ibuki2003/nanoradio/board/miniradio0913.kicad_pcb

## KiCad design board/miniradio0913.kicad_pcb (2024-10-18)

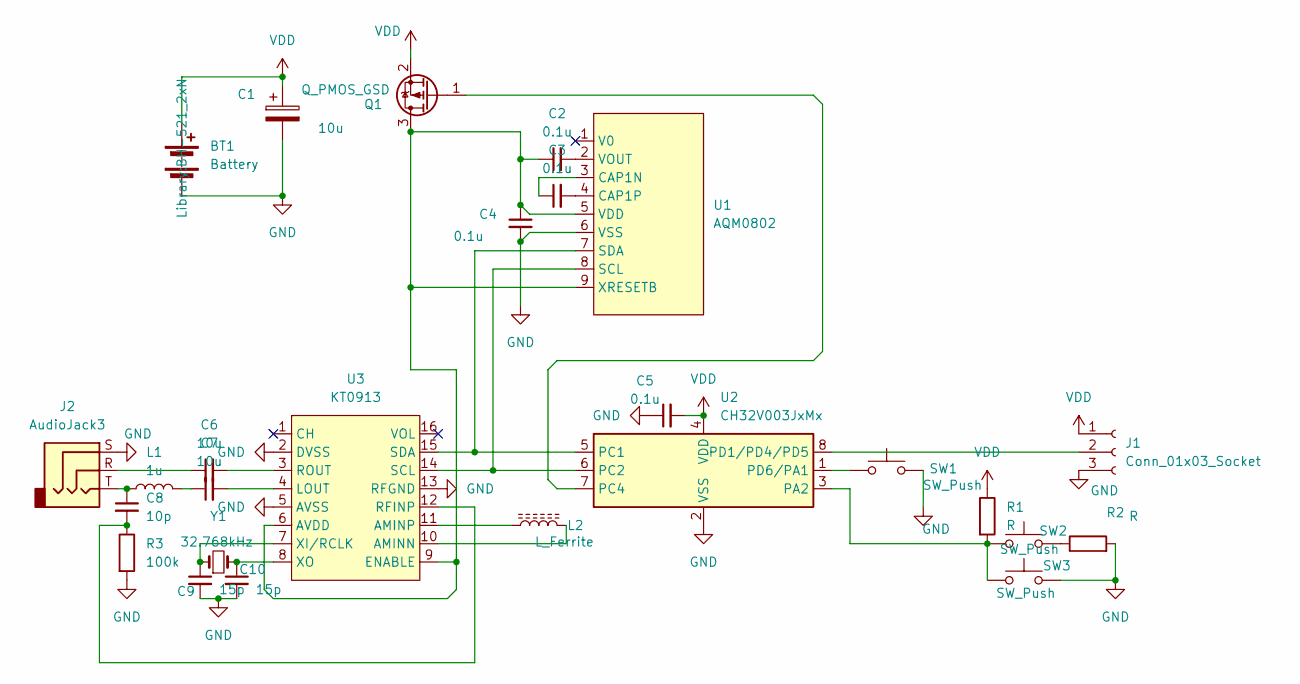
[picture p1: schematic miniradio0913.kicad_sch]

Parts:
BT1: Battery; BH-521_2xN
C1, C6, C7: 10u; C_0603_1608Metric
C2, C3, C4, C5: 0.1u; C_0603_1608Metric
C8: 10p; C_0603_1608Metric
C9, C10: 15p; C_0603_1608Metric
J1: Conn_01x03_Socket; DebugPoint_2.54mmx3
J2: AudioJack3; Jack_3.5mm_Switronic_ST-005-G_horizontal
L1: 1u; L_0603_1608Metric
L2: L_Ferrite; L_Axial_L7.0mm_D3.3mm_P10.16mm_Horizontal_Fastron_MICC
Q1: Q_PMOS_GSD; SOT-23
R1, R2: R; R_0603_1608Metric
R3: 100k; R_0603_1608Metric
SW1, SW2, SW3: SW_Push; SW_SPST_PTS810
U1: AQM0802; AQM0802A
U2: CH32V003JxMx; SOP-8_3.9x4.9mm_P1.27mm
U3: KT0913; SSOP-16_3.9x4.9mm_P0.635mm
Y1: 32.768kHz; Crystal_SMD_3215-2Pin_3.2x1.5mm

Connections:
GND: BT1.2 (-), C1.2, C4.2, C5.1, C9.2, C10.2, J1.3, J2.S, R2.2, R3.2, SW1.2, SW3.2, U1.6 (VSS), U2.2 (VSS), U3.2 (DVSS), U3.5 (AVSS), U3.13 (RFGND)
unnamed: C6.1, J2.R
unnamed: C7.1, L1.2
unnamed: C8.1, J2.T, L1.1
unnamed: J1.2, U2.8 (PD1/PD4/PD5)
unnamed: C2.1, C4.1, Q1.3 (D), U1.5 (VDD), U1.9 (XRESETB), U3.6 (AVDD), U3.9 (ENABLE)
unnamed: Q1.1 (G), U2.7 (PC4)
unnamed: R2.1, SW2.2
unnamed: C3.1, U1.3 (CAP1N)
unnamed: C3.2, U1.4 (CAP1P)
unnamed: U1.8 (SCL), U2.6 (PC2), U3.14 (SCL)
unnamed: U1.7 (SDA), U2.5 (PC1), U3.15 (SDA)
unnamed: C2.2, U1.2 (VOUT)
unnamed: R1.2, SW2.1, SW3.1, U2.3 (PA2)
unnamed: SW1.1, U2.1 (PD6/PA1)
unnamed: L2.1, U3.10 (AMINN)
unnamed: L2.2, U3.11 (AMINP)
unnamed: C7.2, U3.4 (LOUT)
unnamed: C8.2, R3.1, U3.12 (RFINP)
unnamed: C6.2, U3.3 (ROUT)
unnamed: C9.1, U3.7 (XI/RCLK), Y1.1
unnamed: C10.1, U3.8 (XO), Y1.2
VDD: BT1.1 (+), C1.1, C5.2, J1.1, Q1.2 (S), R1.1, U2.4 (VDD)

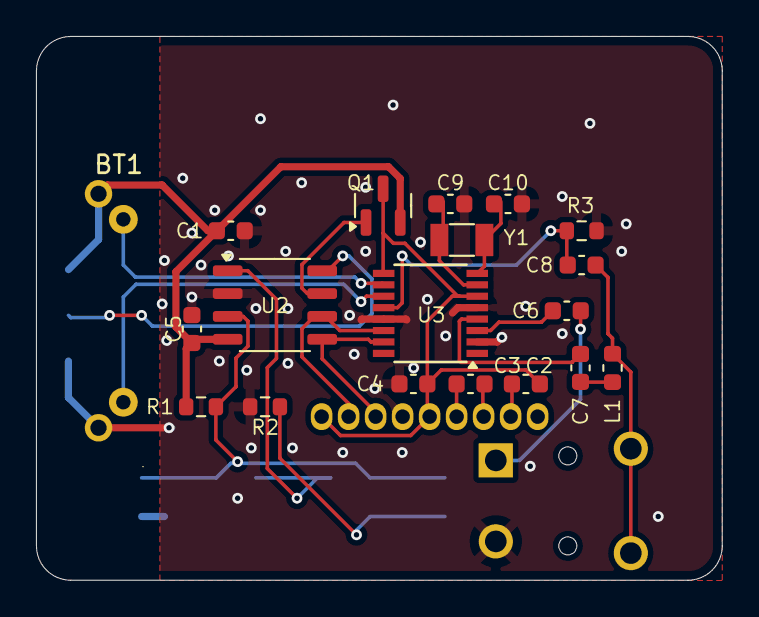
[picture p2: board miniradio0913.kicad_pcb from above]

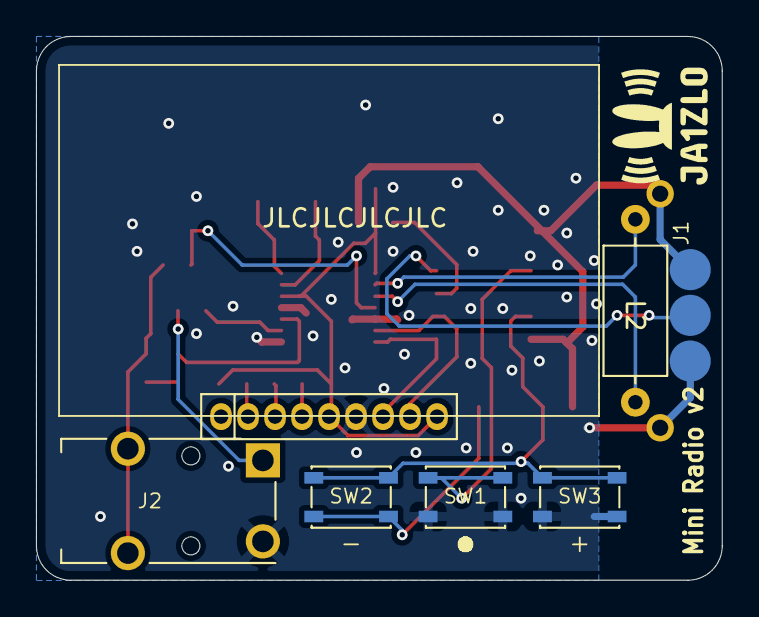
[picture p3: board miniradio0913.kicad_pcb from below]

Board: 2 copper layers, 38.1 x 30.2 mm, 26 parts (7 on the bottom side), 23 nets.
