ibuki2003/nanoradio/program/src/lcd_kana.h

#pragma once

#define ｡ "\xa1"
#define ｢ "\xa2"
#define ｣ "\xa3"
#define ､ "\xa4"
#define ･ "\xa5"
#define ｦ "\xa6"
#define ｧ "\xa7"
#define ｨ "\xa8"
#define ｩ "\xa9"
#define ｪ "\xaa"
#define ｫ "\xab"
#define ｬ "\xac"
#define ｭ "\xad"
#define ｮ "\xae"
#define ｯ "\xaf"

#define ｰ "\xb0"
#define ｱ "\xb1"
#define ｲ "\xb2"
#define ｳ "\xb3"
#define ｴ "\xb4"
#define ｵ "\xb5"
#define ｶ "\xb6"
#define ｷ "\xb7"
#define ｸ "\xb8"
#define ｹ "\xb9"
#define ｺ "\xba"
#define ｻ "\xbb"
#define ｼ "\xbc"
#define ｽ "\xbd"
#define ｾ "\xbe"
#define ｿ "\xbf"

#define ﾀ "\xc0"
#define ﾁ "\xc1"
#define ﾂ "\xc2"
#define ﾃ "\xc3"
#define ﾄ "\xc4"
#define ﾅ "\xc5"
#define ﾆ "\xc6"
#define ﾇ "\xc7"
#define ﾈ "\xc8"
#define ﾉ "\xc9"
#define ﾊ "\xca"
#define ﾋ "\xcb"
#define ﾌ "\xcc"
#define ﾍ "\xcd"
#define ﾎ "\xce"
#define ﾏ "\xcf"

#define ﾐ "\xd0"
#define ﾑ "\xd1"
#define ﾒ "\xd2"
#define ﾓ "\xd3"
#define ﾔ "\xd4"
#define ﾕ "\xd5"
#define ﾖ "\xd6"
#define ﾗ "\xd7"
#define ﾘ "\xd8"
#define ﾙ "\xd9"
#define ﾚ "\xda"
#define ﾛ "\xdb"
#define ﾜ "\xdc"
#define ﾝ "\xdd"
#define ﾞ "\xde"
#define ﾟ "\xdf"
