ibuki2003/nanoradio/program/src/i2c.c

#include "i2c.h"
#include <ch32v003fun.h>

uint8_t i2c_send(uint8_t addr, const uint8_t *data, uint8_t sz);
uint8_t i2c_recv(uint8_t addr, uint8_t *data, uint8_t sz);
uint8_t i2c_send_recv(uint8_t addr, const uint8_t* send, uint8_t send_size, uint8_t* recv, uint8_t recv_size);

#define TIMEOUT_MAX 100000
#define WAIT_WHILE_TIMEOUT(expr) { int32_t timeout = TIMEOUT_MAX; while((expr) && --timeout); if(timeout==0) return 1; }

inline static uint8_t i2c_chk_evt(uint32_t event_mask) {
  /* read order matters here! STAR1 before STAR2!! */
  uint32_t status = I2C1->STAR1 | (I2C1->STAR2<<16);
  return (status & event_mask) == event_mask;
}

uint8_t i2c_raw_start(uint8_t addr, bool recv)
{
  // start

  // Set START condition
  I2C1->CTLR1 |= I2C_CTLR1_START | (recv ? I2C_CTLR1_ACK : 0);

  // wait for master mode select
  WAIT_WHILE_TIMEOUT(!i2c_chk_evt(I2C_EVENT_MASTER_MODE_SELECT));

  // send 7-bit address + write flag
  I2C1->DATAR = addr<<1 | (recv ? 1 : 0);

  // wait for condition
  if (recv) {
    WAIT_WHILE_TIMEOUT(!i2c_chk_evt(I2C_EVENT_MASTER_RECEIVER_MODE_SELECTED));
  } else {
    WAIT_WHILE_TIMEOUT(!i2c_chk_evt(I2C_EVENT_MASTER_TRANSMITTER_MODE_SELECTED));
  }

  return 0;
}

uint8_t i2c_raw_send(const uint8_t *data, uint8_t sz, bool last)
{

  // send data one byte at a time
  while(sz--) {
    // wait for TX Empty
    WAIT_WHILE_TIMEOUT(!(I2C1->STAR1 & I2C_STAR1_TXE));

    // send command
    I2C1->DATAR = *data++;
  }

  if (last) {

    // wait for tx complete
    WAIT_WHILE_TIMEOUT(!i2c_chk_evt(I2C_EVENT_MASTER_BYTE_TRANSMITTED));

    // set STOP condition
    I2C1->CTLR1 |= I2C_CTLR1_STOP;
  }

  // we're happy
  return 0;
}

uint8_t i2c_raw_recv(uint8_t *data, uint8_t sz, bool last)
{

  // send data one byte at a time
  while(sz--) {
    if (sz == 0) {
      // last
      I2C1->CTLR1 |= I2C_CTLR1_ACK;
      if (last) I2C1->CTLR1 |= I2C_CTLR1_STOP;
    }

    // wait for RX Ready
    WAIT_WHILE_TIMEOUT(!i2c_chk_evt(I2C_EVENT_MASTER_BYTE_RECEIVED));

    // send command
    *data++ = I2C1->DATAR;
  }

  // we're happy
  return 0;
}

void i2c_setup();
