ibuki2003/nanoradio/(commit log)

2024-07-20 add board
    [miniradio0913.kicad_pcb, miniradio0913.kicad_sch]
2024-07-20 fix(board): crystal
    [miniradio0913.kicad_pcb, miniradio0913.kicad_sch]
2024-07-20 feat: add i2c lib
2024-08-11 board: update
    [miniradio0913.kicad_pcb, miniradio0913.kicad_sch]
2024-08-20 feat: update i2c lib
2024-08-20 feat: update board (release v1)
2024-08-22 feat: update i2c libs
2024-08-22 fix: wait for i2c ready before start to use
    [i2c.h]
2024-08-22 feat: update buttons logic
2024-08-22 fix: radio freq range
    [kt0913.h]
2024-08-23 fix: decrease i2c speed
    [i2c.h]
2024-08-23 fix: set freq on mode change
    [main.c]
2024-08-23 fix: update wakeup logic
    [main.c]
2024-09-10 feat(board): update layout
    [miniradio0913.kicad_pcb]
2024-10-15 board: renumber parts
    [miniradio0913.kicad_pcb, miniradio0913.kicad_sch]
2024-10-15 board: fix wiring
    [miniradio0913.kicad_pcb]
2024-10-18 update board
    [miniradio0913.kicad_pcb]
2024-11-08 fix: set am freq after wakeup
    [main.c]
